okzo/Ipomoea-cairica/readme.md

# Ipomoea-cairica

60% JP or US Keyboard

このキーボードは組み立て時に日本語かUS配列を選択できます。

## JP
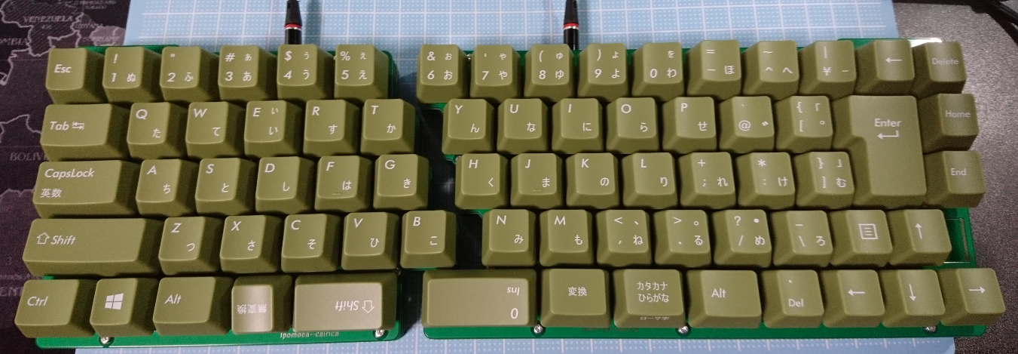
[picture p1: build_guide/ipomoea-cairica-jp.png]


## US
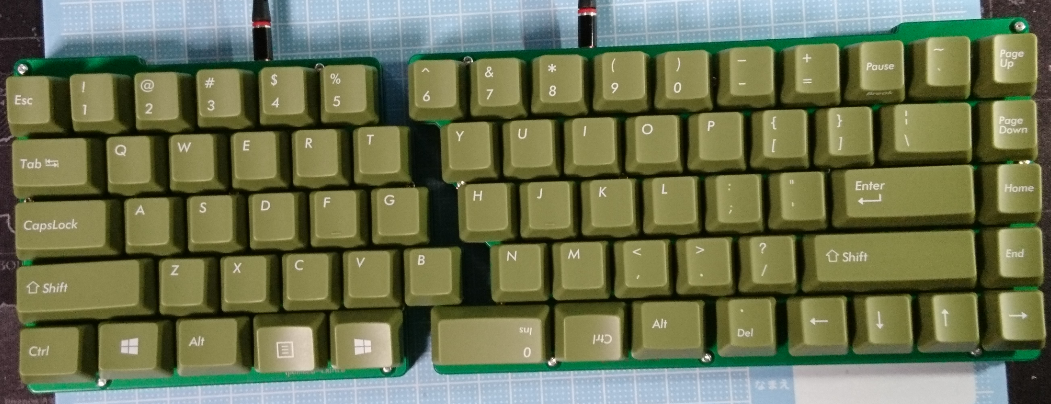
[picture p2: build_guide/ipomoea-cairica-us.png]


## 組み立て方

[こちら](build_guide/build_guide.md)
