okzo/Ipomoea-cairica/Ipomoea-cairica/Ipomoea-cairica-board_LEFT.kicad_pcb

## KiCad design Ipomoea-cairica/Ipomoea-cairica-board_LEFT.kicad_pcb (2020-03-29)

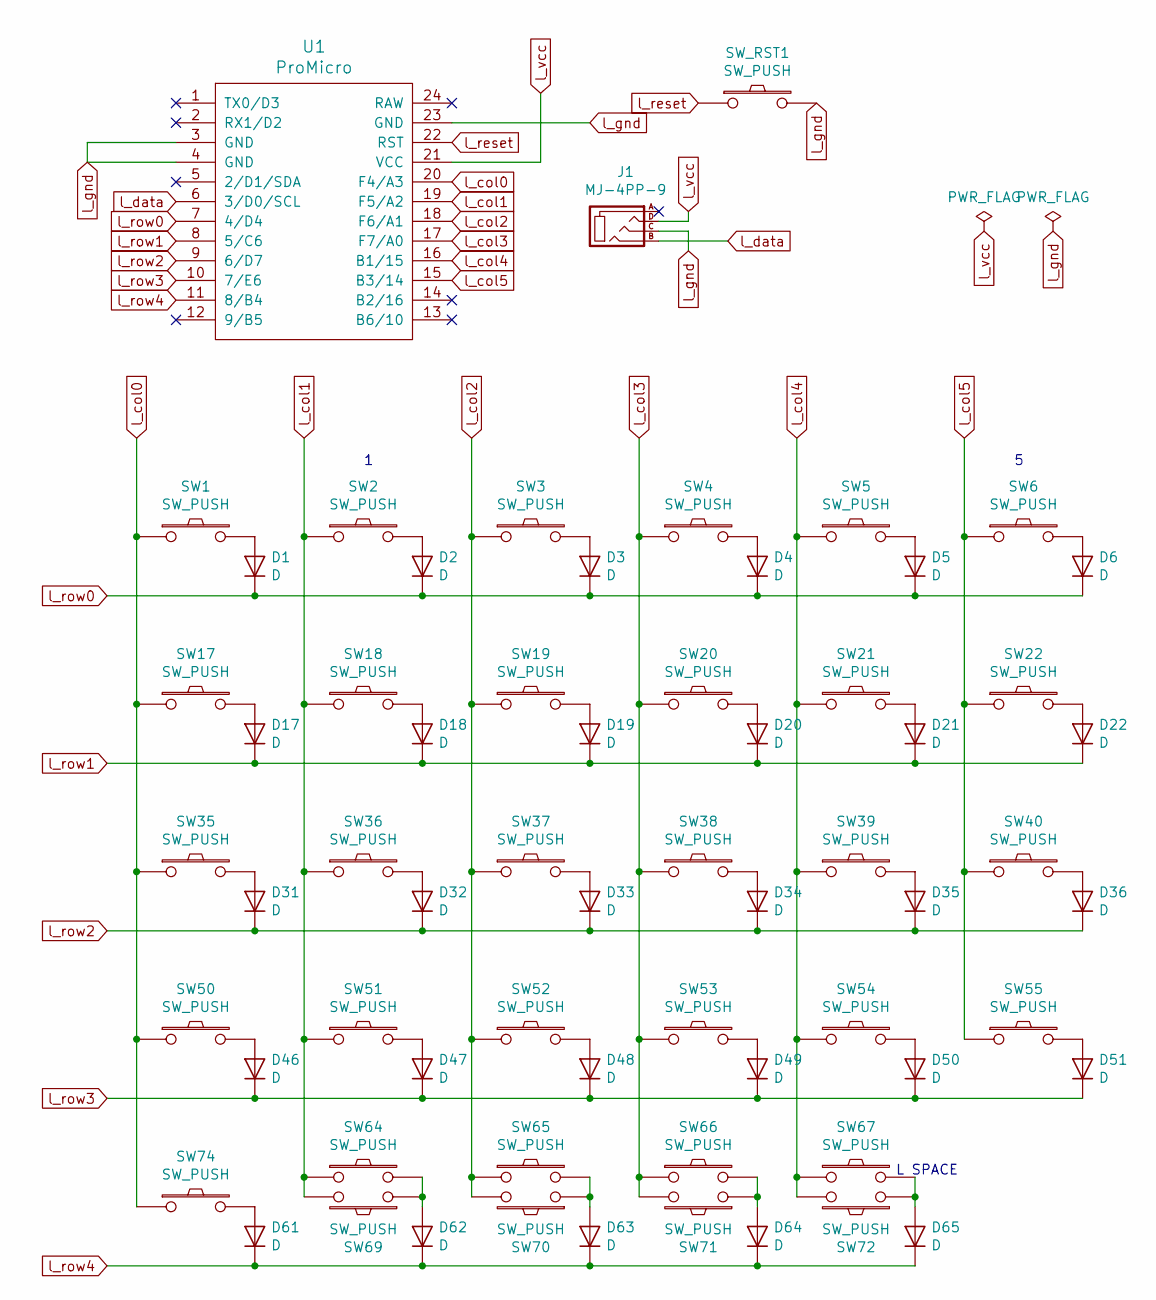
[picture p38: schematic Ipomoea-cairica-board_LEFT.sch]

Parts:
D1, D2, D3, D4, D5, D6, D17, D18, D19, D20, D21, D22, D31, D32, D33, D34, D35, D36, D46, D47, D48, D49, D50, D51, D61, D62, D63, D64, D65: D; D3_TH_SMD
J1: MJ-4PP-9; MJ-4PP-9_1side
SW1, SW2, SW3: SW_PUSH; CherryMX-Hotswap_1u_ProMicro
SW4: SW_PUSH; CherryMX-Hotswap_1u_TRRS
SW5, SW6, SW18, SW19, SW20, SW21, SW22, SW36, SW37, SW38, SW39, SW40, SW51, SW52, SW53, SW54, SW55, SW64, SW66: SW_PUSH; CherryMX-Hotswap_1u
SW17: SW_PUSH; CherryMX-Hotswap_1.5u
SW35, SW67: SW_PUSH; CherryMX-Hotswap_1.75u
SW50: SW_PUSH; CherryMX-Hotswap_2.25u
SW65, SW69, SW70, SW71, SW72, SW74: SW_PUSH; CherryMX-Hotswap_1.25u
SW_RST1: SW_PUSH; ResetSW_1side
U1: ProMicro

Connections:
unnamed: D1.2 (A), SW1.2
unnamed: D2.2 (A), SW2.2
unnamed: D3.2 (A), SW3.2
unnamed: D4.2 (A), SW4.2
unnamed: D5.2 (A), SW5.2
unnamed: D6.2 (A), SW6.2
unnamed: D17.2 (A), SW17.2
unnamed: D18.2 (A), SW18.2
unnamed: D19.2 (A), SW19.2
unnamed: D20.2 (A), SW20.2
unnamed: D21.2 (A), SW21.2
unnamed: D22.2 (A), SW22.2
unnamed: D31.2 (A), SW35.2
unnamed: D32.2 (A), SW36.2
unnamed: D33.2 (A), SW37.2
unnamed: D34.2 (A), SW38.2
unnamed: D35.2 (A), SW39.2
unnamed: D36.2 (A), SW40.2
unnamed: D46.2 (A), SW50.2
unnamed: D47.2 (A), SW51.2
unnamed: D48.2 (A), SW52.2
unnamed: D49.2 (A), SW53.2
unnamed: D50.2 (A), SW54.2
unnamed: D51.2 (A), SW55.2
unnamed: D61.2 (A), SW74.2
unnamed: D62.2 (A), SW64.2, SW69.1
unnamed: D63.2 (A), SW65.2, SW70.1
unnamed: D64.2 (A), SW66.2, SW71.1
unnamed: D65.2 (A), SW67.2, SW72.1
l_col0: SW1.1, SW17.1, SW35.1, SW50.1, SW74.1, U1.20 (F4/A3)
l_col1: SW2.1, SW18.1, SW36.1, SW51.1, SW64.1, SW69.2, U1.19 (F5/A2)
l_col2: SW3.1, SW19.1, SW37.1, SW52.1, SW65.1, SW70.2, U1.18 (F6/A1)
l_col3: SW4.1, SW20.1, SW38.1, SW53.1, SW66.1, SW71.2, U1.17 (F7/A0)
l_col4: SW5.1, SW21.1, SW39.1, SW54.1, SW67.1, SW72.2, U1.16 (B1/15)
l_col5: SW6.1, SW22.1, SW40.1, SW55.1, U1.15 (B3/14)
l_data: J1.B, U1.6 (3/D0/SCL)
l_gnd: J1.C, SW_RST1.2, U1.3 (GND), U1.4 (GND), U1.23 (GND)
l_reset: SW_RST1.1, U1.22 (RST)
l_row0: D1.1 (K), D2.1 (K), D3.1 (K), D4.1 (K), D5.1 (K), D6.1 (K), U1.7 (4/D4)
l_row1: D17.1 (K), D18.1 (K), D19.1 (K), D20.1 (K), D21.1 (K), D22.1 (K), U1.8 (5/C6)
l_row2: D31.1 (K), D32.1 (K), D33.1 (K), D34.1 (K), D35.1 (K), D36.1 (K), U1.9 (6/D7)
l_row3: D46.1 (K), D47.1 (K), D48.1 (K), D49.1 (K), D50.1 (K), D51.1 (K), U1.10 (7/E6)
l_row4: D61.1 (K), D62.1 (K), D63.1 (K), D64.1 (K), D65.1 (K), U1.11 (8/B4)
l_vcc: J1.D, U1.21 (VCC)

Notes on the sheet:
L SPACE

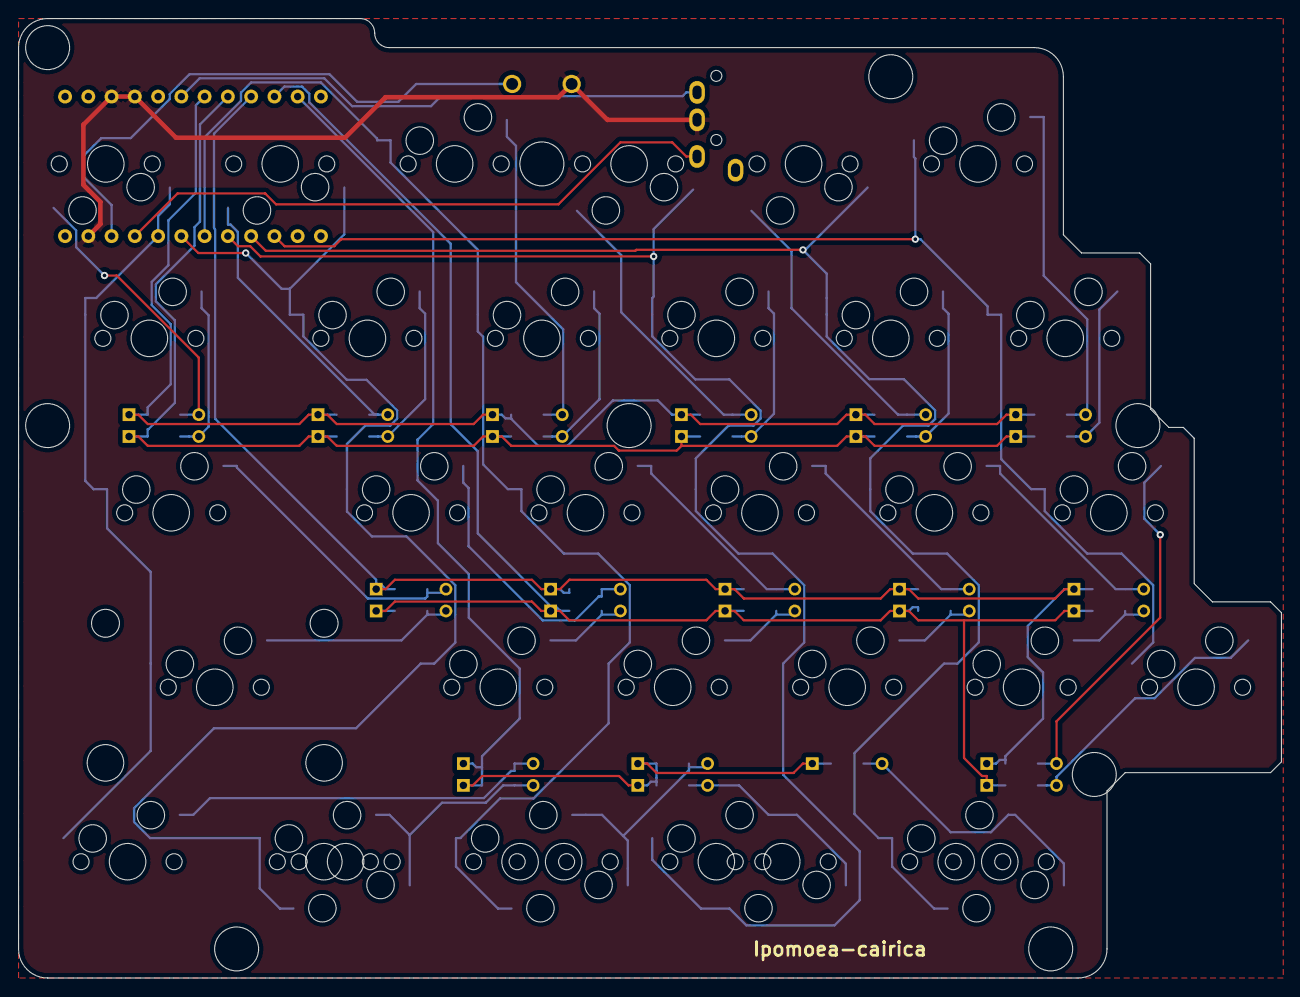
[picture p39: board Ipomoea-cairica-board_LEFT.kicad_pcb from above]

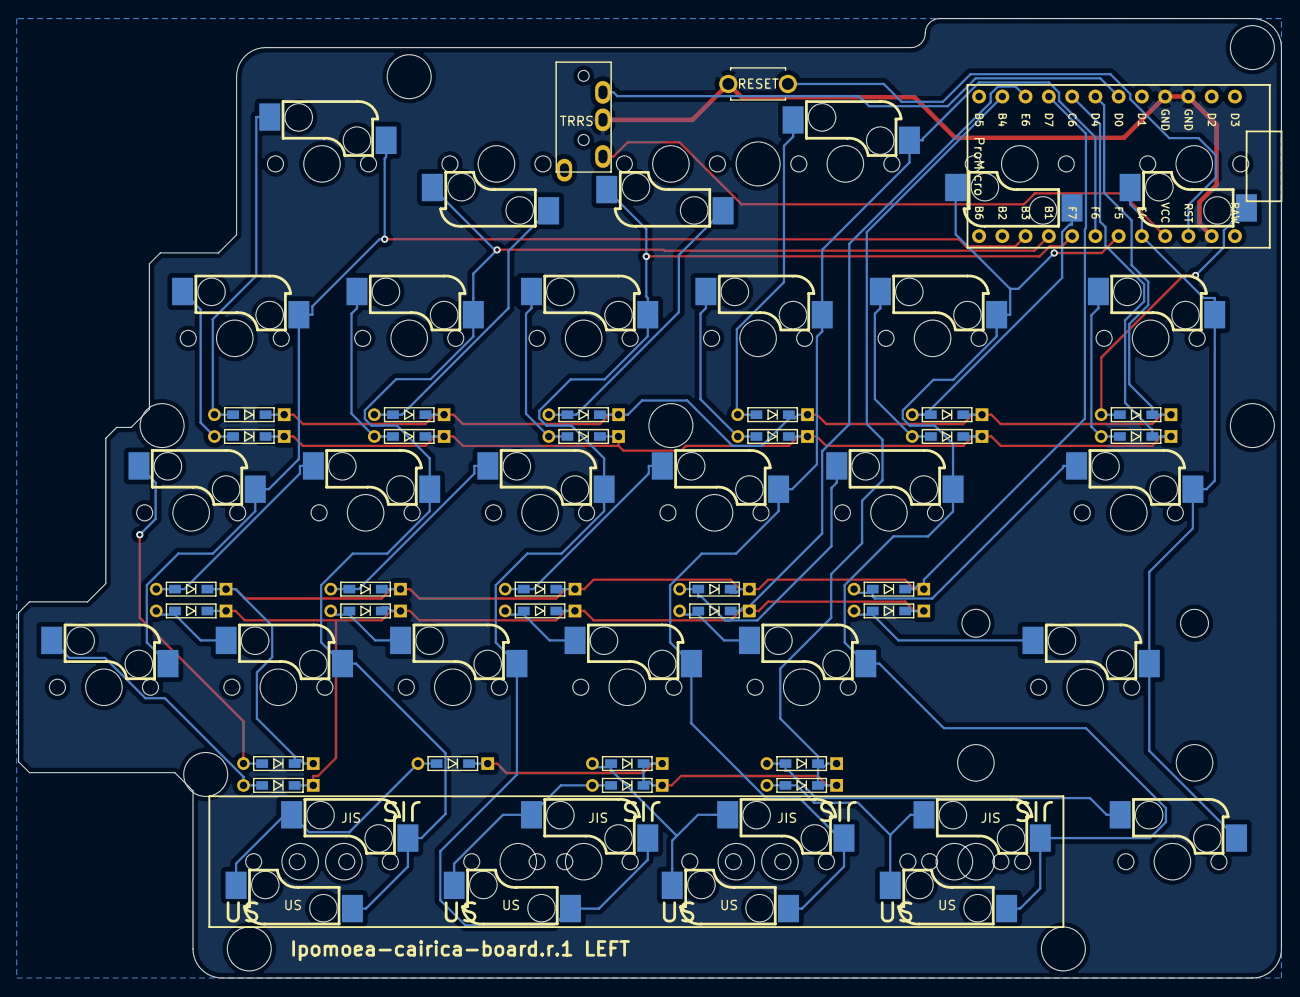
[picture p40: board Ipomoea-cairica-board_LEFT.kicad_pcb from below]

Board: 2 copper layers, 137.9 x 104.8 mm, 75 parts (2 on the bottom side), 44 nets.

Other parts of the board:
CUT_HOLE_CENTER: CUT_HOLE_CENTER_LEFT
M2_SPACER_HOLE_001, M2_SPACER_HOLE_005, M2_SPACER_HOLE_006, M2_SPACER_HOLE_008, M2_SPACER_HOLE_014, M2_SPACER_HOLE_015, M2_SPACER_HOLE_016, M2_SPACER_HOLE_018, M2_SPACER_HOLE_020: Val**; M2_SPACER_HOLE
