okzo/Ipomoea-cairica/Ipomoea-cairica/Ipomoea-cairica-board_RIGHT.kicad_pcb

## KiCad design Ipomoea-cairica/Ipomoea-cairica-board_RIGHT.kicad_pcb (2020-03-29)

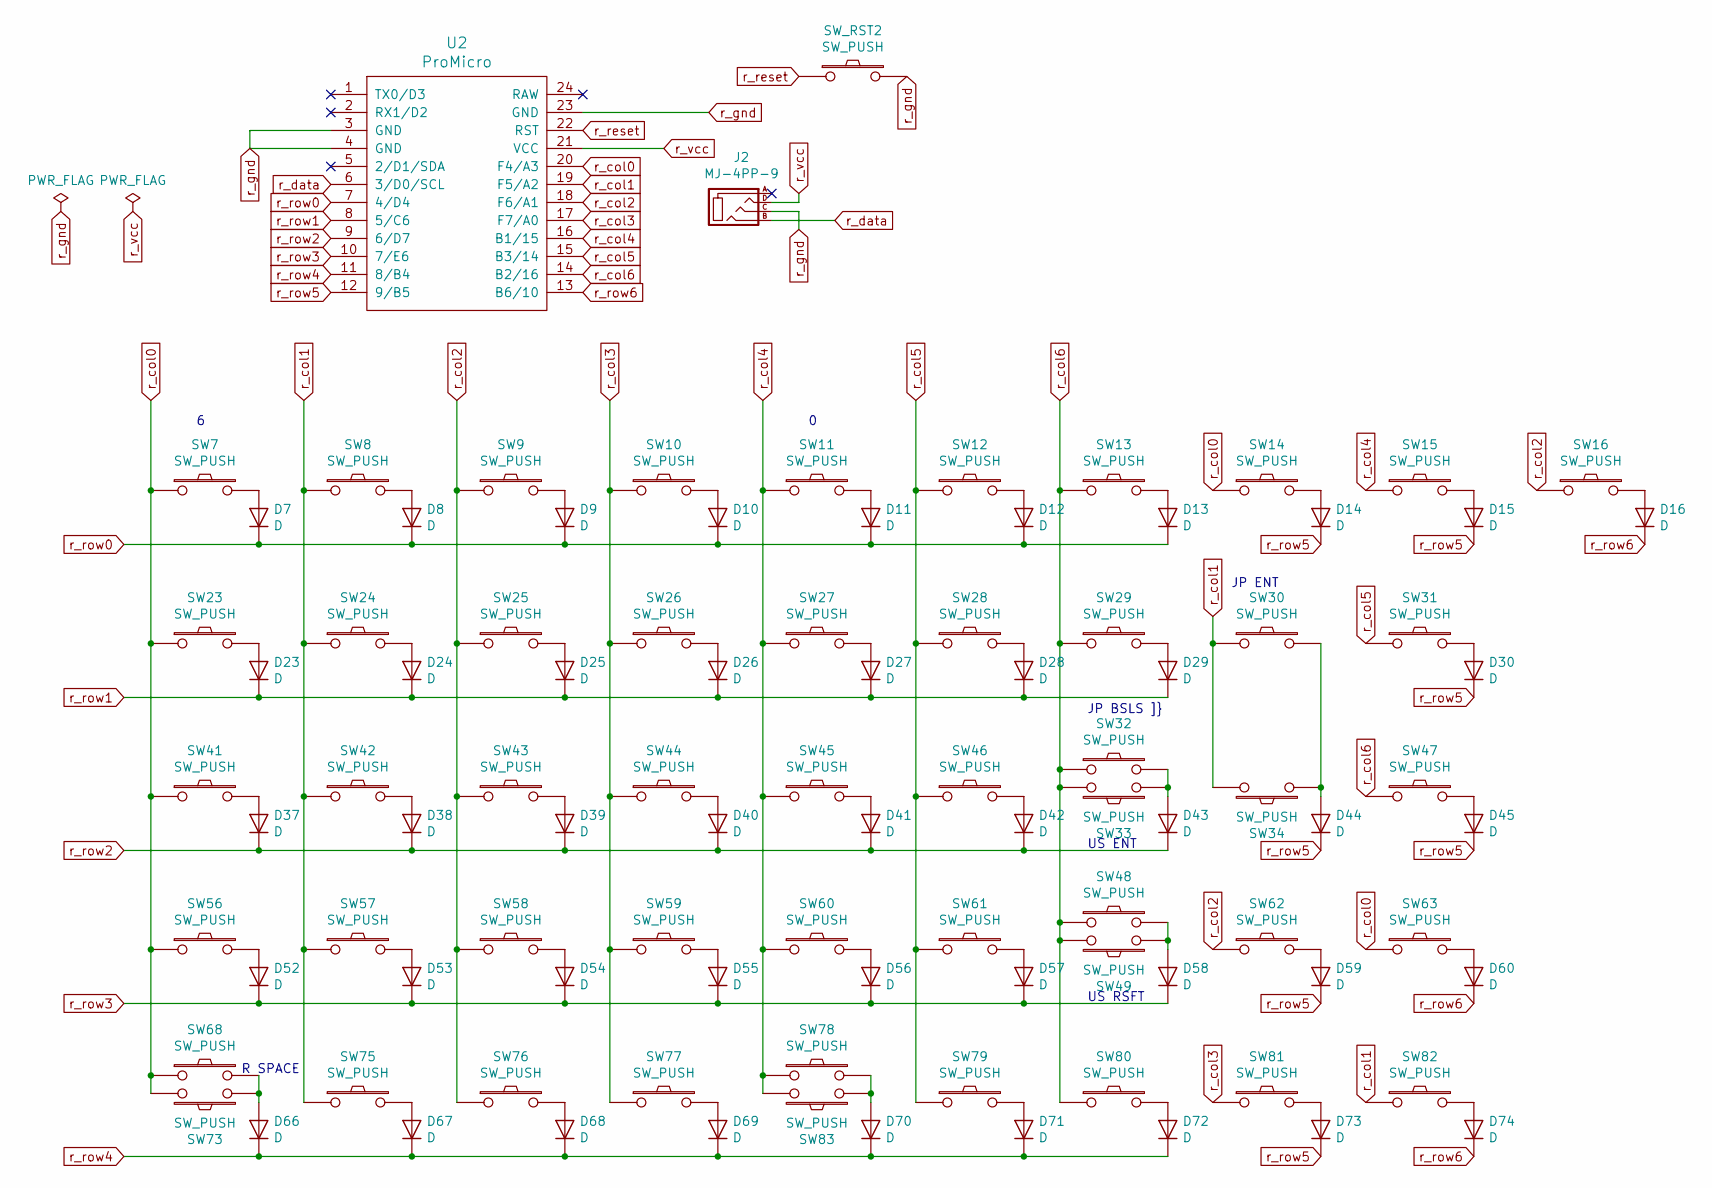
[picture p41: schematic Ipomoea-cairica-board_RIGHT.sch]

Parts:
D7, D8, D9, D10, D11, D12, D13, D14, D15, D16, D23, D24, D25, D26, D27, D28, D29, D30, D37, D38, D39, D40, D41, D42, D43, D44, D45, D52, D53, D54, D55, D56, D57, D58, D59, D60, D66, D67, D68, D69, D70, D71, D72, D73, D74: D; D3_TH_SMD
J2: MJ-4PP-9; MJ-4PP-9_1side
SW7, SW8, SW10, SW11, SW12, SW14, SW23, SW24, SW25, SW26, SW27, SW28, SW29, SW31, SW32, SW41, SW42, SW43, SW44, SW45, SW46, SW47, SW48, SW56, SW57, SW58, SW59, SW60, SW61, SW62, SW63, SW75, SW79, SW80, SW81, SW82, SW83: SW_PUSH; CherryMX-Hotswap_1u
SW9: SW_PUSH; CherryMX-Hotswap_1u_TRRS
SW13, SW15, SW16: SW_PUSH; CherryMX-Hotswap_1u_ProMicro
SW30: SW_PUSH; CherryMX-Hotswap_1.5u_BackSlash
SW33: SW_PUSH; CherryMX-Hotswap_2.25u
SW34: SW_PUSH; CherryMX-Hotswap_2u
SW49: SW_PUSH; CherryMX-Hotswap_2.75u
SW68: SW_PUSH; CherryMX-Hotswap_2u_RSFT
SW73: SW_PUSH; CherryMX-Hotswap_1u_RSFT_1
SW76, SW77, SW78: SW_PUSH; CherryMX-Hotswap_1.25u
SW_RST2: SW_PUSH; ResetSW_1side
U2: ProMicro

Connections:
unnamed: D7.2 (A), SW7.2
unnamed: D8.2 (A), SW8.2
unnamed: D9.2 (A), SW9.2
unnamed: D10.2 (A), SW10.2
unnamed: D11.2 (A), SW11.2
unnamed: D12.2 (A), SW12.2
unnamed: D13.2 (A), SW13.2
unnamed: D14.2 (A), SW14.2
unnamed: D15.2 (A), SW15.2
unnamed: D16.2 (A), SW16.2
unnamed: D23.2 (A), SW23.2
unnamed: D24.2 (A), SW24.2
unnamed: D25.2 (A), SW25.2
unnamed: D26.2 (A), SW26.2
unnamed: D27.2 (A), SW27.2
unnamed: D28.2 (A), SW28.2
unnamed: D29.2 (A), SW29.2
unnamed: D30.2 (A), SW31.2
unnamed: D37.2 (A), SW41.2
unnamed: D38.2 (A), SW42.2
unnamed: D39.2 (A), SW43.2
unnamed: D40.2 (A), SW44.2
unnamed: D41.2 (A), SW45.2
unnamed: D42.2 (A), SW46.2
unnamed: D43.2 (A), SW32.2, SW33.1
unnamed: D44.2 (A), SW30.2, SW34.1
unnamed: D45.2 (A), SW47.2
unnamed: D52.2 (A), SW56.2
unnamed: D53.2 (A), SW57.2
unnamed: D54.2 (A), SW58.2
unnamed: D55.2 (A), SW59.2
unnamed: D56.2 (A), SW60.2
unnamed: D57.2 (A), SW61.2
unnamed: D58.2 (A), SW48.2, SW49.1
unnamed: D59.2 (A), SW62.2
unnamed: D60.2 (A), SW63.2
unnamed: D66.2 (A), SW68.2, SW73.1
unnamed: D67.2 (A), SW75.2
unnamed: D68.2 (A), SW76.2
unnamed: D69.2 (A), SW77.2
unnamed: D70.2 (A), SW78.2, SW83.1
unnamed: D71.2 (A), SW79.2
unnamed: D72.2 (A), SW80.2
unnamed: D73.2 (A), SW81.2
unnamed: D74.2 (A), SW82.2
r_col0: SW7.1, SW14.1, SW23.1, SW41.1, SW56.1, SW63.1, SW68.1, SW73.2, U2.20 (F4/A3)
r_col1: SW8.1, SW24.1, SW30.1, SW34.2, SW42.1, SW57.1, SW75.1, SW82.1, U2.19 (F5/A2)
r_col2: SW9.1, SW16.1, SW25.1, SW43.1, SW58.1, SW62.1, SW76.1, U2.18 (F6/A1)
r_col3: SW10.1, SW26.1, SW44.1, SW59.1, SW77.1, SW81.1, U2.17 (F7/A0)
r_col4: SW11.1, SW15.1, SW27.1, SW45.1, SW60.1, SW78.1, SW83.2, U2.16 (B1/15)
r_col5: SW12.1, SW28.1, SW31.1, SW46.1, SW61.1, SW79.1, U2.15 (B3/14)
r_col6: SW13.1, SW29.1, SW32.1, SW33.2, SW47.1, SW48.1, SW49.2, SW80.1, U2.14 (B2/16)
r_data: J2.B, U2.6 (3/D0/SCL)
r_gnd: J2.C, SW_RST2.2, U2.3 (GND), U2.4 (GND), U2.23 (GND)
r_reset: SW_RST2.1, U2.22 (RST)
r_row0: D7.1 (K), D8.1 (K), D9.1 (K), D10.1 (K), D11.1 (K), D12.1 (K), D13.1 (K), U2.7 (4/D4)
r_row1: D23.1 (K), D24.1 (K), D25.1 (K), D26.1 (K), D27.1 (K), D28.1 (K), D29.1 (K), U2.8 (5/C6)
r_row2: D37.1 (K), D38.1 (K), D39.1 (K), D40.1 (K), D41.1 (K), D42.1 (K), D43.1 (K), U2.9 (6/D7)
r_row3: D52.1 (K), D53.1 (K), D54.1 (K), D55.1 (K), D56.1 (K), D57.1 (K), D58.1 (K), U2.10 (7/E6)
r_row4: D66.1 (K), D67.1 (K), D68.1 (K), D69.1 (K), D70.1 (K), D71.1 (K), D72.1 (K), U2.11 (8/B4)
r_row5: D14.1 (K), D15.1 (K), D30.1 (K), D44.1 (K), D45.1 (K), D59.1 (K), D73.1 (K), U2.12 (9/B5)
r_row6: D16.1 (K), D60.1 (K), D74.1 (K), U2.13 (B6/10)
r_vcc: J2.D, U2.21 (VCC)

Notes on the sheet:
R SPACE
US RSFT
US ENT
JP BSLS ]}
JP ENT

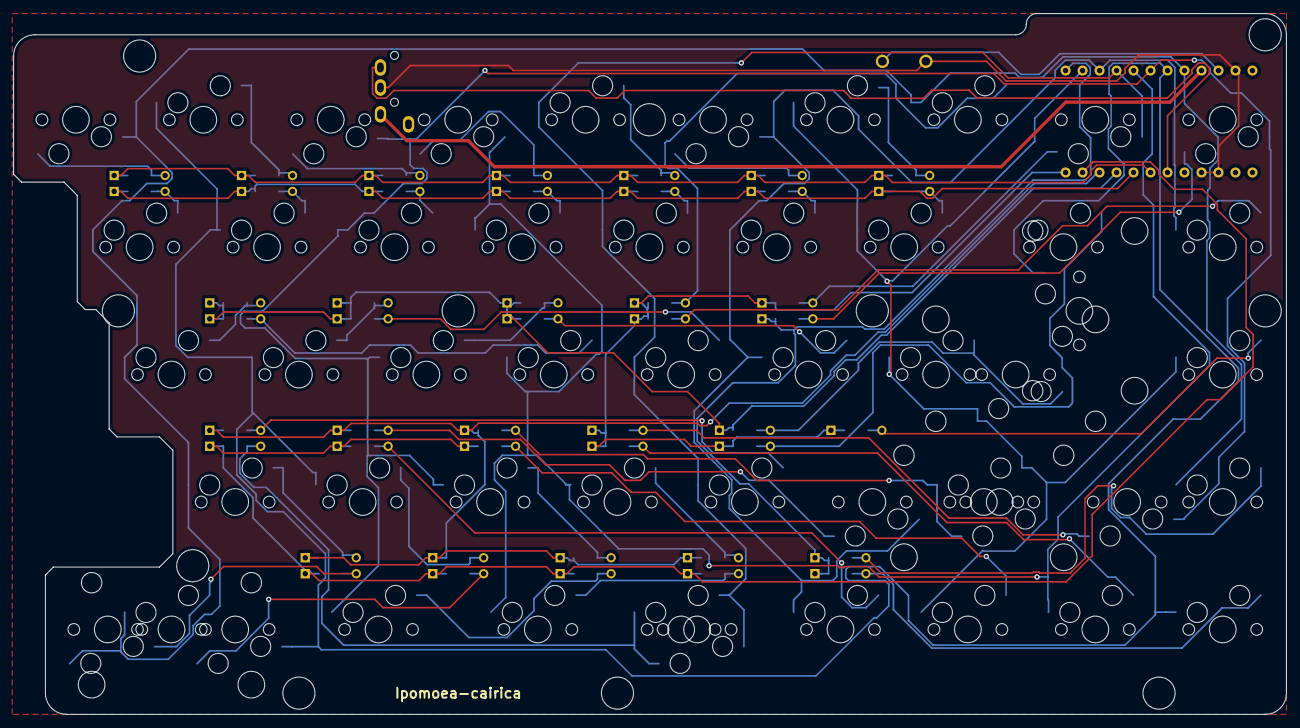
[picture p42: board Ipomoea-cairica-board_RIGHT.kicad_pcb from above]

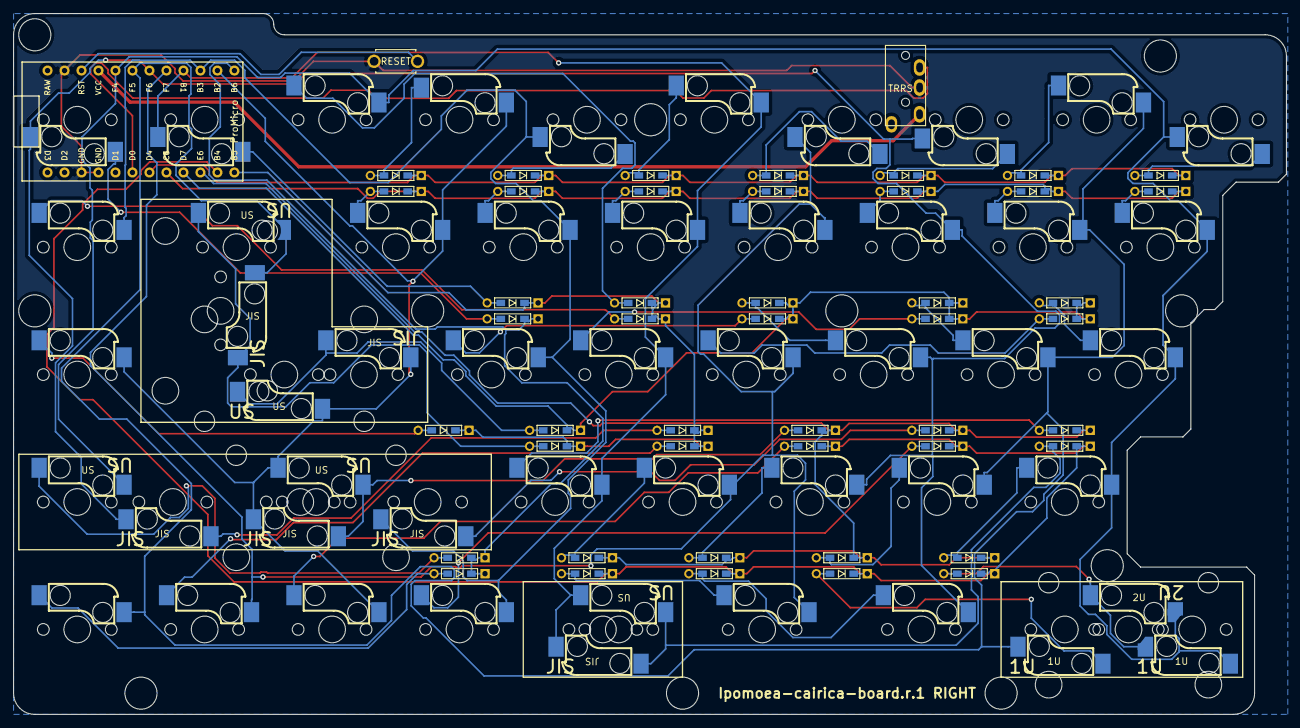
[picture p43: board Ipomoea-cairica-board_RIGHT.kicad_pcb from below]

Board: 2 copper layers, 190.3 x 104.8 mm, 110 parts (2 on the bottom side), 63 nets.

Other parts of the board:
CUT_HOLE_CENTER: CUT_HOLE_CENTER_RIGHT
M2_SPACER_HOLE_002, M2_SPACER_HOLE_003, M2_SPACER_HOLE_004, M2_SPACER_HOLE_007, M2_SPACER_HOLE_009, M2_SPACER_HOLE_010, M2_SPACER_HOLE_011, M2_SPACER_HOLE_012, M2_SPACER_HOLE_013, M2_SPACER_HOLE_017, M2_SPACER_HOLE_019: Val**; M2_SPACER_HOLE
